Skai-126/CS3237-Final-Project/data/README.md

# Data

Raw sensor recordings are **not committed** (they get large). Store them in the shared drive / cloud bucket and describe each dataset here.

| Dataset | Collected by | Date | Sensors | Rows | Location / link | Notes |
|---|---|---|---|---|---|---|
| | | | | | | |

Small samples (< 1 MB) for testing can go in `data/samples/`.
