Skai-126/CS3237-Final-Project/hardware/datasheets/README.md

# Datasheets

Datasheets (or links to them) for every sensor, actuator and module we use.

| Part | Datasheet |
|---|---|
| | |
