Skai-126/CS3237-Final-Project/hardware/enclosure/README.md

# Enclosure

3D-print models (STL/STEP), CAD source files and case designs go here.
