Skai-126/CS3237-Final-Project/docs/reports/README.md

# Reports & presentations

- `check-in-1/`: slides for Week 9
- `check-in-2/`: slides for Week 11
- `final/`: final report (≤ 20 pages) and presentation (13 Nov)
- `power-analysis/`: battery-life measurements and sampling-interval experiments
