Skai-126/CS3237-Final-Project/docs/ideas/CS3237_Group3_Project_Ideas.docx

CS3237 Introduction to IoT

# Group 3: Project Ideas

Compiled by Shu Kai · Updated 26 September 2026 · For discussion before the proposal deadline

Proposal due: Monday 28 September, 23:59 (Canvas). We need to pick one idea very soon so there is time to write it up. Please read through the ideas and the notes, then vote.

# 1. The brief in short

Group 3: Chang Shu Kai, Loh Wern She, Ng Ren Jie Daniel, Tan Chyn, Toh Xiang Yi Thomas. Lecturer: Jingxian Wang (wang@nus.edu.sg).

We need to build a complete IoT system: ESP32 devices, an optional gateway (smartphone) and a server (laptop or cloud). The focus is on:

- Real-time processing at the edge of critical data that needs instant action (e.g. fall detection, motion-based security).
- Long-term analytics in the cloud (e.g. activity trends).

## Must-haves from the project spec

- At least two ESP32 devices and more than one sensor, with the sensor data used together.
- ESP32s powered by a power bank (more impressive) or mains/laptop, with no communication over the USB cable.
- Communication via REST and/or MQTT; phone gateway (if used) talks to the cloud over Wi-Fi.
- Machine learning in the cloud for analytics, trained on our own sensor data (web data can only supplement it).
- Live inference in the final demo.
- Power-management analysis in the report: battery-life estimate on a LiPo, and the effect of different sampling intervals.
- Extra hardware budget: S$60 per group.
- Bonus points for RTOS features, bare-metal programming, detailed power analysis, 3D printing and other novelty. An AI-agent extension is optional.

## Timeline and grading

When | What | Weight
Mon 28 Sep, 23:59 | Project proposal (Canvas) | 10%
Week 9 | Check-in 1 (feedback on proposal) + Peer Review 1 | 5%
Week 11 | Check-in 2 (preliminary assessment incl. demo) | 5%
Fri 13 Nov | Final demo + presentation | 20%
Fri 13 Nov, 23:59 | Final report (max 20 pages) | 15%
Weeks 9 and 13 | Peer reviews (5% for completing both) | 5%

The project is marked on novelty, difficulty and complexity, technical work (sensing and ML), quality of the final solution, and quality of the presentation, demo and report.

Past projects (novelty is lower if we pick one of these): heat injury prevention, elderly health monitor, dementia monitoring, fall detection, heat stroke detection, weather prediction, fridge stock monitoring, fish tank monitoring, smart rubbish bin, driver state detection, smart baby monitor.

# 2. The ideas

## Idea 1: Smart Clothing Drying Rack

Proposed by Wern She. Predicts when clothes are dry and protects them from rain or high humidity.

Component | Details
ESP32 #1 | Humidity and temperature sensors
ESP32 #2 | Light, moisture and rain sensors
Edge action (real-time) | Retracts or covers the clothes as soon as rain is detected
Actuator | Servo motor moves a cover or the drying rack
ML | Predicts drying time from humidity, temperature, sunlight and fabric weight
Cloud (long-term) | Analyses drying performance across different weather conditions
Demo | Wet cloth samples; simulate rain with a spray bottle

### Notes against the brief

- Clear split between the edge (rain → cover) and the cloud (drying-time prediction).
- Fabric weight means adding a load cell; that also gives a direct "is it dry yet" signal (weight stops dropping).
- Collecting enough real drying runs to train on takes time, so data collection needs to start early.

## Idea 2: Smart Waste Bin with Fill-Level and Odour Prediction

Proposed by Wern She. A bin that detects its fill level, identifies waste conditions and predicts when it needs to be collected.

Component | Details
ESP32 #1 | Ultrasonic sensor for fill level
ESP32 #2 | Gas, temperature, humidity and weight sensors
Edge action (real-time) | Show a warning or operate a lid mechanism
ML | Predict when the bin will overflow, or classify normal vs abnormal odour conditions
Cloud (long-term) | Collection trends and estimated next collection time
Demo | Add objects to the bin and simulate different waste conditions
Stretch | Camera to classify recyclable vs non-recyclable waste (not required for the project to work)

### Notes against the brief

- Cheap and low-risk hardware; mostly kit sensors.
- Smart rubbish bins are on the course's list of past projects, so we would need a clear twist to score on novelty.
- Overlaps with idea 4 and could be merged with it (see below).

## Idea 3: Smart Dormitory Energy-Waste Detector

Proposed by Wern She. Detects appliances being left on unnecessarily.

Component | Details
ESP32 #1 | Current sensor and temperature sensor
ESP32 #2 | Motion, light and door sensors
Edge action (real-time) | Turn off a simulated appliance when no one is present
ML | Learn normal room-usage patterns; tell apart normal use, unusual consumption and possible overheating
Cloud (long-term) | Energy consumption trends and estimated wasted energy
Demo | Leave a lamp or fan running while simulating an empty room

### Notes against the brief

- Strong real-world motivation, and the long-term energy analytics fit the cloud requirement well.
- Switching a real mains appliance is a safety risk. Stick to a low-voltage (USB) fan or lamp driven through a relay.
- A current sensor (e.g. a clamp-on type) will probably need to be bought.

## Idea 4: Smart AI Sorting Bin

Proposed by Chyn. Identifies the type of waste dropped in using computer vision, then sorts it into the correct compartment using a rotating funnel.

Component | Details
ESP32 #1 (base) | Drives a NEMA17 stepper (rotates the funnel to the right bin) and an MG996R servo (tilts the funnel to drop the item)
ESP32 #2 | Ultrasonic sensor for bin fill level and/or a weight sensor for item weight and capacity
ESP32-CAM | Mounted at the top; photographs each item for classification
Edge action (real-time) | After classification, the base rotates the funnel to the matching bin and triggers the servo to drop the item
ML | Image classifier (recyclable material types vs general waste) running on the ESP32-CAM via Edge Impulse or TFLite Micro
Cloud (long-term) | Dashboard showing sorting accuracy over time, waste category breakdown and fill trends per compartment
Demo | Drop different items in front of the camera one at a time; the system classifies each, rotates to the matching bin and drops it in, live
Inspiration | ameru.ai (design); James Dyson Award 2026 "Smart Recycling Bin" by Malaysian students

### Possible extensions

- Extension 1: robot-arm sorting. A separate unit: an ordinary bin where everything is thrown in mixed. A dedicated ESP32 drives an arm with its own camera looking into the bin, picks out individual items and places each into the correct sorted bin. We could 3D-print an open-source arm and focus only on the CV and inverse kinematics.
- Extension 2: multi-bin routing (also works with idea 2). Each bin's ESP32 publishes its fill level over MQTT to a server, which runs a simple nearest-neighbour greedy route over bins above a fill threshold to suggest a collection order.

### Notes against the brief

- The most impressive demo, and it scores on technical difficulty and possible bonus points (3D printing, RTOS timing for the motors).
- The ML here runs on the edge. The spec requires ML in the cloud as well, so we'd add something like fill-level forecasting or model retraining from misclassified images.
- Has the most mechanical risk (funnel, stepper driver, jams). NEMA17 + driver + MG996R + ESP32-CAM need to fit the S$60 budget, and the stepper needs its own power supply.
- The robot arm (extension 1) is a big jump in scope; probably only worth it if the base system is working by Check-in 2.

## Idea 5: Smart Fridge System

Proposed by Thomas. Monitors food availability, storage conditions and consumption patterns, and notifies the user through an app when an item is missing or running low.

Component | Details
ESP32 #1 | Temperature and humidity sensors for fridge conditions
ESP32 #2 | Load cells / weight sensors, door sensor, optional gas/VOC sensor
Edge action (real-time) | Immediately detects a missing or low-stock item and triggers an LED, buzzer or display
Actuator | Servo could automatically close a model fridge door or control an air vent
ML | Learns consumption patterns and predicts when commonly used items will run out; estimates spoilage risk from temperature, humidity, storage time and gas readings
App | Notifications such as "Milk is running low" or "Eggs are no longer detected"
Cloud (long-term) | Consumption history, fridge conditions and predicted restocking times
Demo | Put items on the load cells, remove one, and show the app receiving a notification

### Notes against the brief

- Clean, easy-to-explain demo, and the phone app naturally fills the optional gateway role.
- "Monitoring food stock levels in fridge" is on the list of past projects, so novelty would need to come from the freshness/spoilage side.
- Consumption patterns take weeks to build up for real; we would likely need to simulate usage to train the forecasting model.

## Idea 6: Smart Wireless Interference Detection System

Proposed by Ren Jie. A distributed system that detects areas with abnormal Wi-Fi or cellular connectivity and identifies possible interference.

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

### Notes against the brief

- Novel compared to the past-project list and needs no extra hardware, and the multi-node comparison is a real use of "collective" sensing.
- The spec requires more than one sensor. Wi-Fi measurements come from the radio, so we should add at least one physical sensor (e.g. temperature or motion) to be safe.
- The system should only detect interference. Deliberately jamming radio signals is illegal, so the demo must stay with the safe methods listed above.
- Few natural actuators; the edge action is mainly an alert.

## Idea 7: Predictive Maintenance for Motors and Fans

NEW Proposed by Claude (new suggestion). Monitors a motor or fan for abnormal vibration, heat and current draw, shuts it down instantly when something dangerous happens, and learns its wear pattern over time. This is an Industrial IoT use case.

Component | Details
ESP32 #1 | IMU / accelerometer (vibration) + temperature sensor clipped onto the fan or motor housing
ESP32 #2 | Current sensor on the fan supply + relay to cut power; optional microphone for acoustic signature
Edge action (real-time) | Vibration or temperature crosses a danger threshold → relay cuts power within milliseconds, buzzer/LED alert
Actuator | Relay (power cut-off); optional fan-speed control
ML | Autoencoder trained on "healthy" data → anomaly score; FFT features + SVM/NN to classify fault type (imbalance, obstruction, loose mount)
Cloud (long-term) | Anomaly score trend, wear over time, estimated time until maintenance, fault log
Demo | Run a small USB/desk fan normally, then tape a coin to one blade or lightly obstruct it; the system detects it and cuts power live

### Notes against the brief

- Industrial IoT is a syllabus topic, and autoencoders/SVMs are covered in lectures.
- Clear edge/cloud split, and data is fast to collect (hours of labelled vibration data in a day). Not on the past-projects list.
- Use a low-voltage (USB/12 V) fan, not a mains appliance, for the relay.
- Running the FFT on the ESP32 and sending only features is good power-analysis material; FreeRTOS tasks and a 3D-printed sensor mount can earn bonus points.

## Idea 8: Dengue Breeding-Site Monitor

NEW Proposed by Claude (new suggestion). Detects stagnant water in containers around the home (plant saucers, pails, gully traps) and drains or flags them before mosquitoes can breed. Tailored to Singapore.

Component | Details
ESP32 #1 | Water-level sensor + waterproof temperature probe (DS18B20) in a container
ESP32 #2 | Second container / location, plus ambient temperature, humidity and light sensors
Edge action (real-time) | Water has stood longer than a threshold → servo tips/opens a drain, LED/buzzer alert
Actuator | Servo tips the container or opens a small drain valve
ML | Breeding-risk model from standing-water duration, water temperature, humidity and rainfall; can be supplemented with NEA dengue-cluster and weather data
Cloud (long-term) | Which containers fill up most often, weekly risk trend, correlation with rainfall, risk per location
Demo | Pour water into the tray; after an accelerated timer the node flags it and the servo drains it; dashboard updates

### Notes against the brief

- Very relevant to Singapore and not on the past-projects list, so it scores well on novelty.
- Stagnant water changes slowly, so the demo and data collection need an accelerated time scale.
- Needs waterproofing, and the tipping/draining mechanism needs a simple, reliable design.

## Idea 9: Library / Study-Spot Seat Monitor

NEW Proposed by Claude (new suggestion). Shows which study seats are really free, detects "seat hogging" (belongings left with nobody there) and forecasts how busy a study area will be.

Component | Details
ESP32 #1 (per desk) | PIR or mmWave presence sensor + pressure pad / load cell on the seat
ESP32 #2 (per desk / area) | Microphone for noise level + light sensor; a second desk for multi-node data
Edge action (real-time) | Items on seat but no person for > N minutes → LED turns amber ("hogged"); instant status change when someone sits or leaves
Actuator | RGB LED / small display showing free / occupied / hogged
ML | Occupancy classifier fusing presence + pressure + noise; LSTM forecasting of area occupancy by time of day
Cloud (long-term) | Occupancy history, peak-hour trends, hogging statistics, predicted free seats in the next hour
App / gateway | Phone app or web page showing a live seat map and forecasts
Demo | Sit down → green to red; leave a bag and walk away → amber after a shortened timer; dashboard shows live map

### Notes against the brief

- A problem every NUS student and marker knows, with a clear, quick demo and cheap hardware.
- Real occupancy data takes time to collect; we would log in an actual study area or simulate usage patterns.
- Keep it privacy-friendly: no cameras, only presence, pressure and noise levels.

# 3. Side-by-side comparison

A quick read of how each idea lines up with what the markers look for. These are my rough judgements to start discussion, not final scores.

Idea | Novelty | Technical depth | Hardware risk | Extra cost | Data collection | Demo impact
1. Drying rack | Medium | Medium | Low | Low | Slow | Good
2. Waste bin | Low | Medium | Low | Low | Medium | OK
3. Energy detector | Medium | Medium | Medium | Medium | Medium | OK
4. AI sorting bin | Med–High | High | High | Medium | Medium | Excellent
5. Smart fridge | Low–Med | Medium | Low | Low | Slow | Good
6. Interference detector | High | Medium | Low | None | Easy | OK
7. Predictive maintenance | Med–High | High | Low | Low | Easy | Good
8. Dengue monitor | High | Medium | Medium | Low | Slow | Good
9. Seat monitor | Medium | Medium | Low | Low | Medium | Good

## Recommendation (for discussion)

- Highest ceiling: Idea 4 + Idea 2 merged. Camera classification and sorting at the edge, with fill-level and waste-mix forecasting across bins in the cloud (this also fixes idea 4's missing cloud ML). To reduce mechanical risk, use a simple servo trapdoor into 2–3 compartments instead of the stepper funnel, and keep the robot arm as a stretch goal.
- Best balance of risk and marks: Idea 7 (predictive maintenance). Cheap, easy to collect lots of data, maps directly to lecture content (autoencoders, Industrial IoT), and the coin-on-fan-blade demo is simple and reliable.
- Safe option: Idea 1 with a Singapore angle. Sudden afternoon storms and HDB laundry poles; the cloud model can add NEA weather data to our own sensor data.

## Possible merge

Ideas 2 and 4 fit together well: the AI sorting bin (edge: camera classification + funnel sorting) plus fill-level/odour sensing and multi-bin MQTT routing (cloud: fill forecasting and collection-route suggestions). That covers both the real-time edge action and the long-term cloud ML that the brief asks for.

# 4. Next steps

- Everyone: vote for your top 2 ideas in the group chat by Sunday 27 Sep.
- Once chosen, split the proposal sections (template: Problem Statement, Proposed Solution, Hardware, ML Models, System Architecture diagram, Other Features, Progress, Challenges, Timeline, References).
- Check the parts list against the kit and the S$60 budget.
- Open question for Jingxian: the spec says a 2-page proposal but the template says 3 pages. Which applies?

CS3237 Group 3 · Project ideas · Page
