Skai-126/CS3237-Final-Project/docs/README.md

# Documentation

| Page | Description |
|---|---|
| [Project brief](project-brief.md) | Summary of the course's project specification and requirements |
| [Proposal](proposal/) | Submitted ZoneSort proposal, changes since, and feedback |
| [Ideas](ideas/) | Candidate ideas we considered before choosing ZoneSort |
| [Meeting notes](meeting-notes/) | Notes from group meetings and check-ins |
| [Reports](reports/) | Final report, check-in slides, power analysis |
