Skai-126/CS3237-Final-Project/docs/meeting-notes/README.md

# Meeting notes

Name files `YYYY-MM-DD.md` (e.g. `2026-09-26.md`). Copy the template below.

```markdown
# Meeting – YYYY-MM-DD
**Attendees:**
**Agenda:**
1.

## Decisions
-

## Action items
| Task | Owner | Due |
|---|---|---|
|  |  |  |
```
