Skai-126/CS3237-Final-Project/docs/proposal/architecture.png

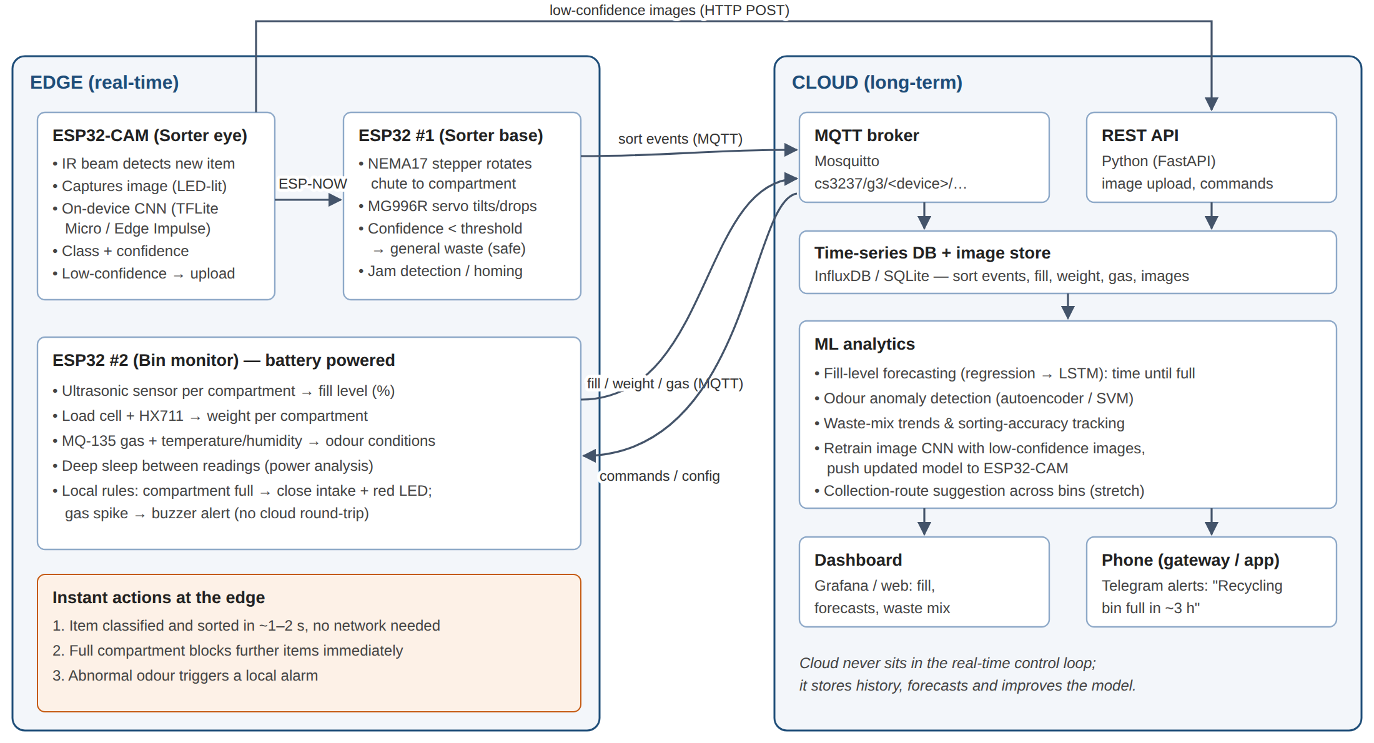
docs/proposal/architecture.png
