Skai-126/CS3237-Final-Project/docs/reports/final/figures/dashboard.png

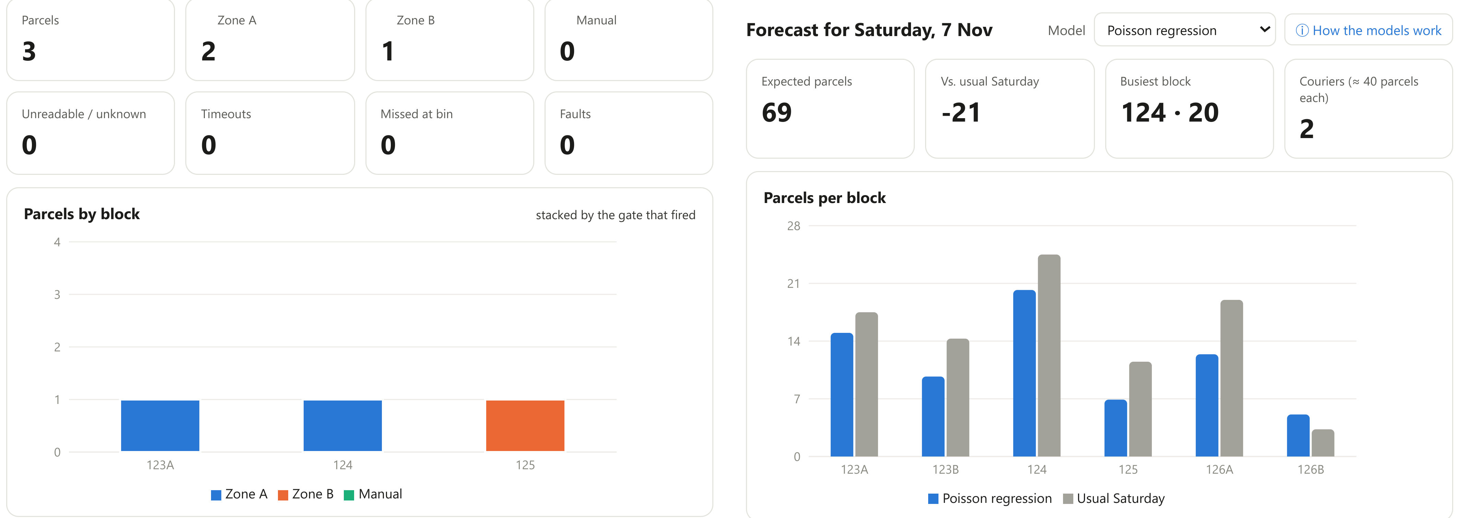
docs/reports/final/figures/dashboard.png
