Skai-126/CS3237-Final-Project/docs/reports/final/figures/forecast_daily_total.png

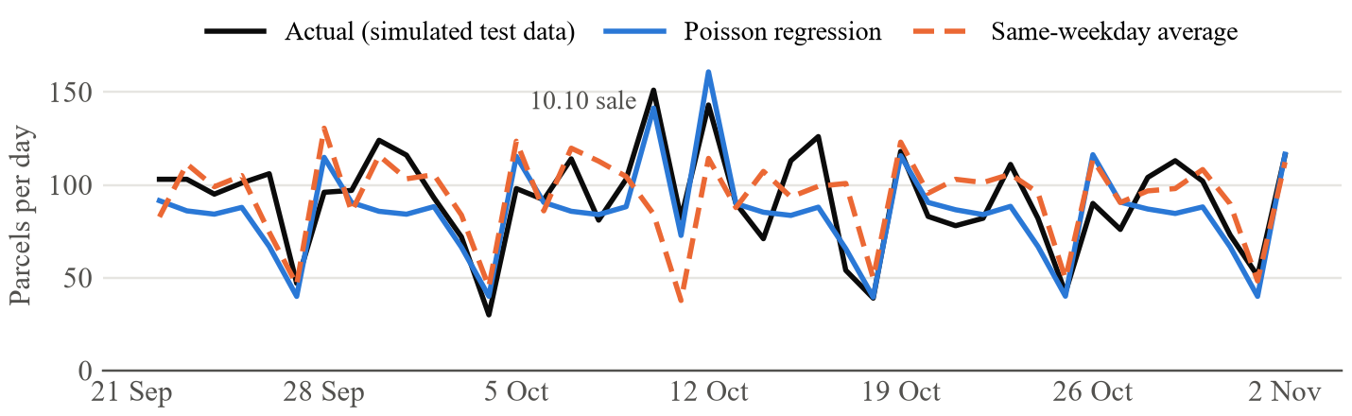
docs/reports/final/figures/forecast_daily_total.png
