Skai-126/CS3237-Final-Project/docs/reports/final/figures/system_architecture.png

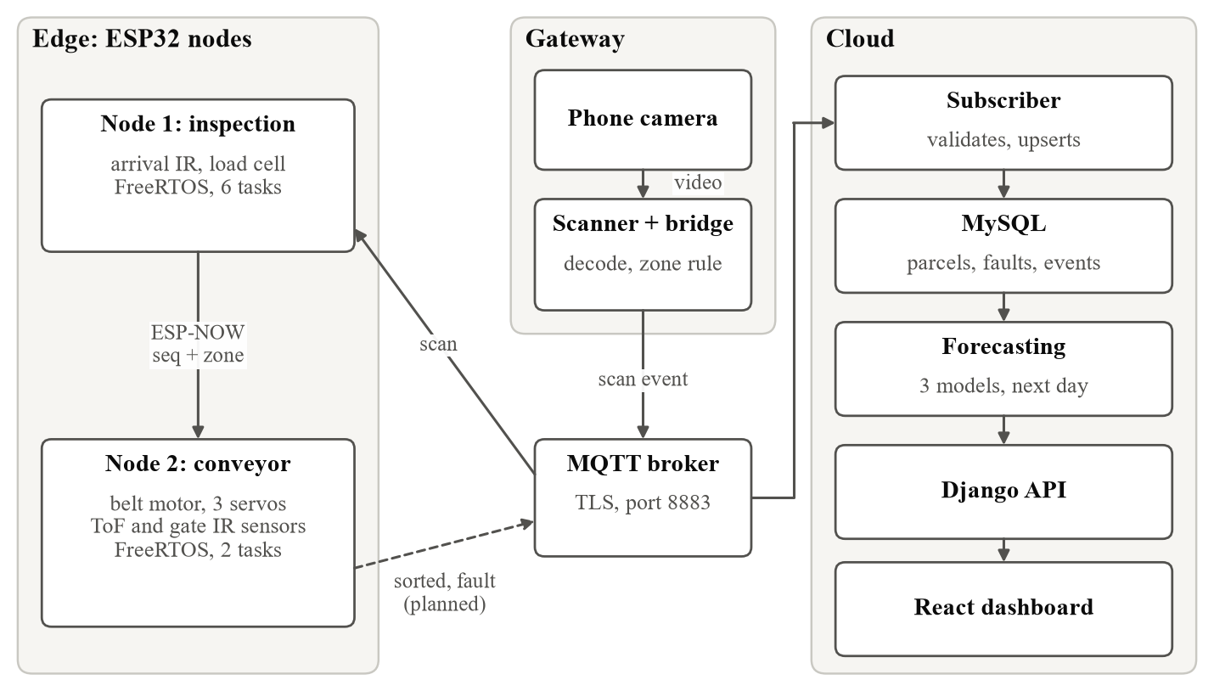
docs/reports/final/figures/system_architecture.png
