Skai-126/CS3237-Final-Project/hardware/enclosure/servo_and_OA_holderver3_mirrored.step

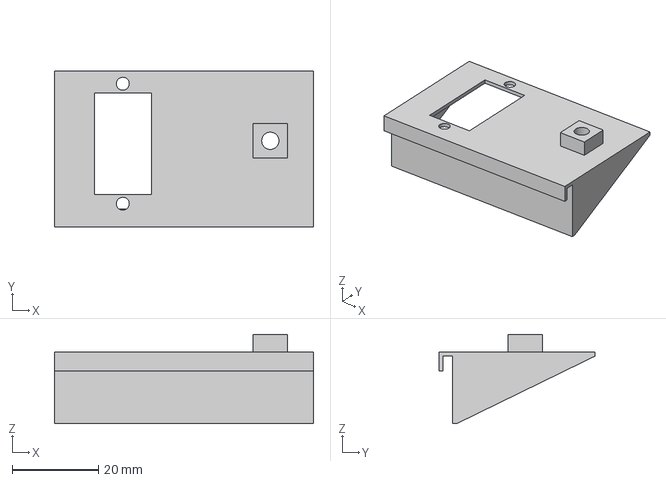
[picture p9: CAD file, 2026-10-30]
hardware/enclosure/servo_and_OA_holderver3_mirrored.step
60.0 x 36.2 x 20.6 mm
