Skai-126/CS3237-Final-Project/hardware/enclosure/Conveyer_belt_box.step

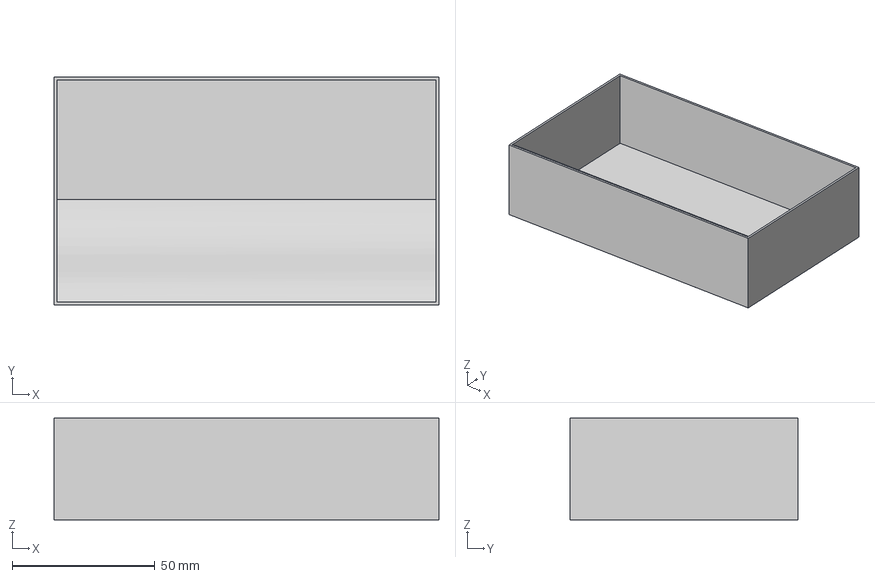
[picture p10: CAD file, 2026-10-30]
hardware/enclosure/Conveyer_belt_box.step
135.0 x 80.0 x 35.7 mm
