Skai-126/CS3237-Final-Project/hardware/enclosure/Motor attachement.step

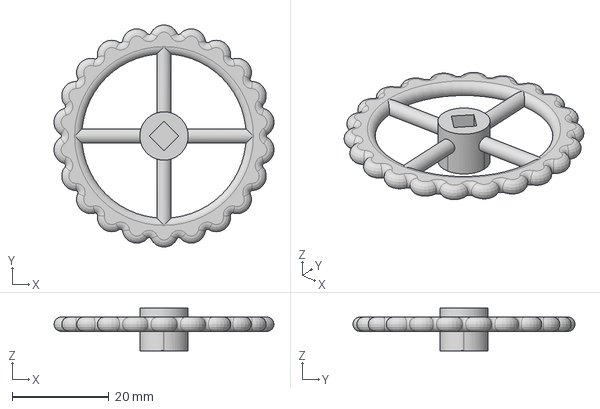
[picture p11: CAD file, 2026-10-30]
hardware/enclosure/Motor attachement.step
45.5 x 46.0 x 8.80 mm
