Skai-126/CS3237-Final-Project/hardware/enclosure/Conveyer_belt_manual_box.step

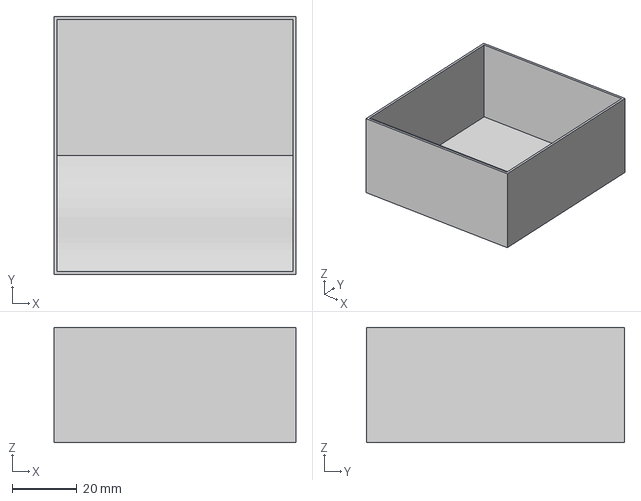
[picture p12: CAD file, 2026-10-30]
hardware/enclosure/Conveyer_belt_manual_box.step
75.0 x 80.0 x 35.7 mm
