Skai-126/CS3237-Final-Project/hardware/enclosure/TOF_holder.step

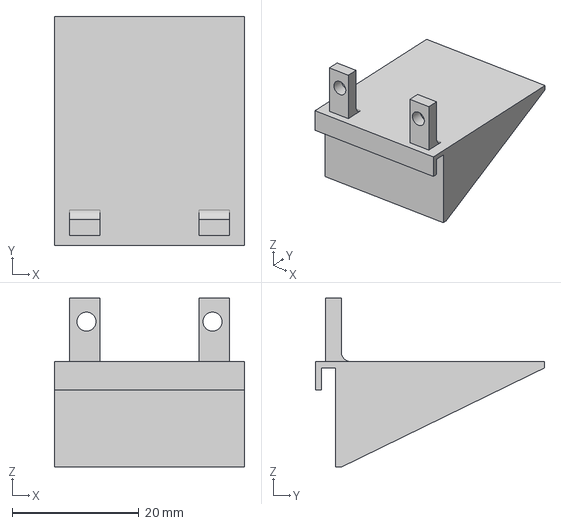
[picture p13: CAD file, 2026-10-30]
hardware/enclosure/TOF_holder.step
30.0 x 36.2 x 26.6 mm
