Skai-126/CS3237-Final-Project/hardware/enclosure/Ramp_Funnel.step

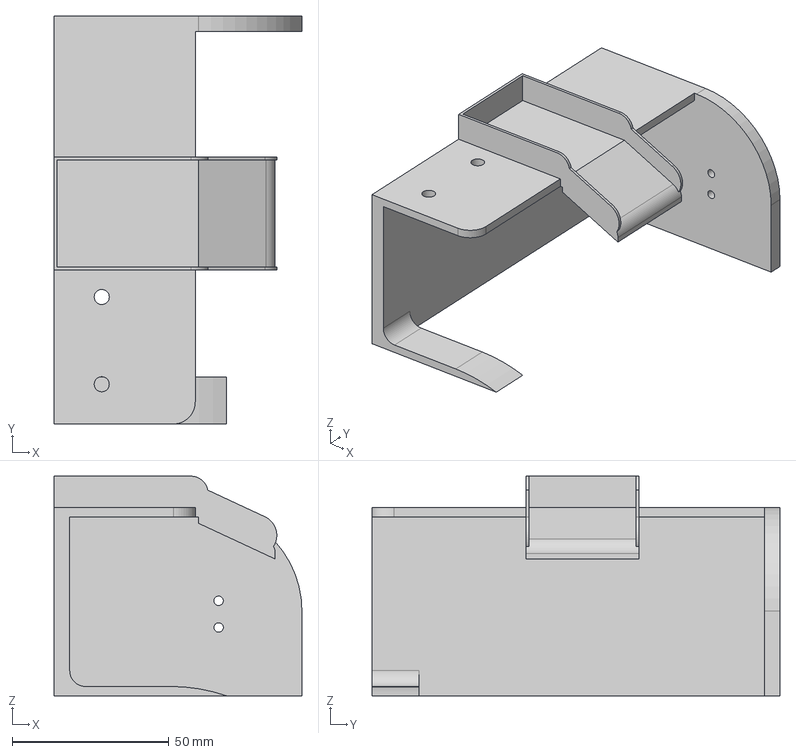
[picture p14: CAD file, 2026-10-30]
hardware/enclosure/Ramp_Funnel.step
79.0 x 130.0 x 70.0 mm
