Skai-126/CS3237-Final-Project/(list of files, cad)

Other CAD files:
hardware/enclosure/servo_and_OA_holderver3.step
