Skai-126/CS3237-Final-Project/cloud/ZoneSort Dashboard.pdf

3

2

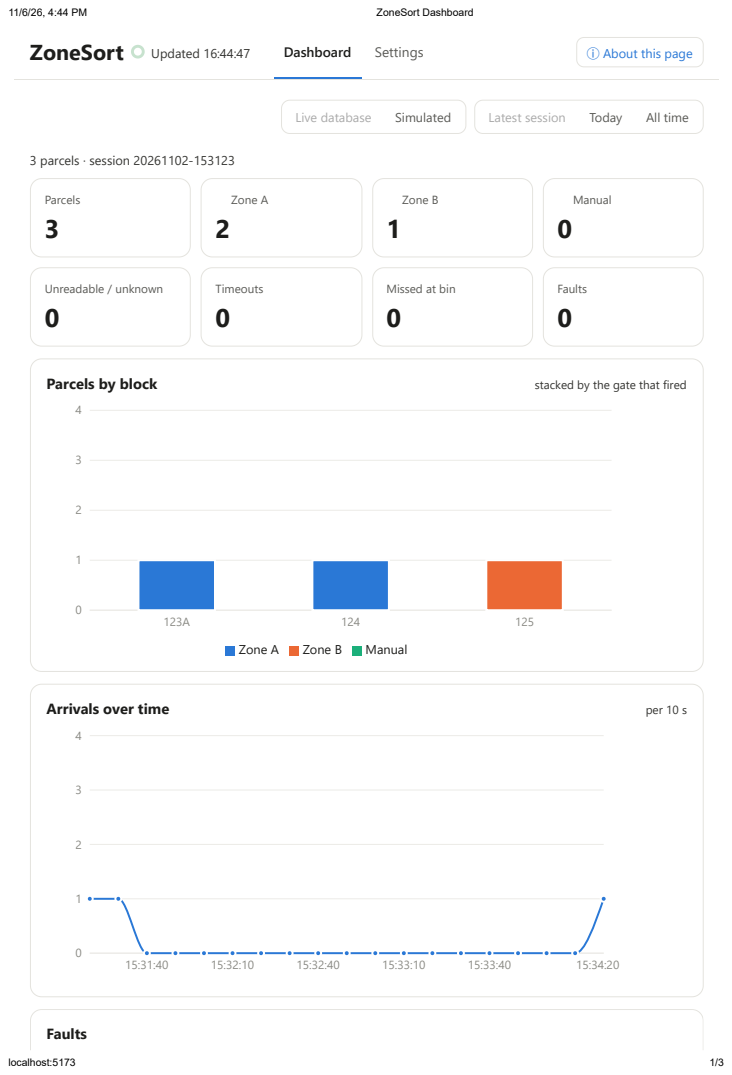
[picture p16: page 1]
Live database; Simulated; Latest session; Today; All time; 3 parcels · session 20261102-153123; Parcels; Zone A; Zone B; Manual; Unreadable / unknown 0; Timeouts 0; Faults 0; Parcels by block; stacked by the gate that fired; Arrivals over time; per 10 s; Faults; ZoneSort Updated 16:44:47; Dashboard; Settings; ⓘ About this page; ZoneSort Dashboard; localhost:5173

Missed at bin

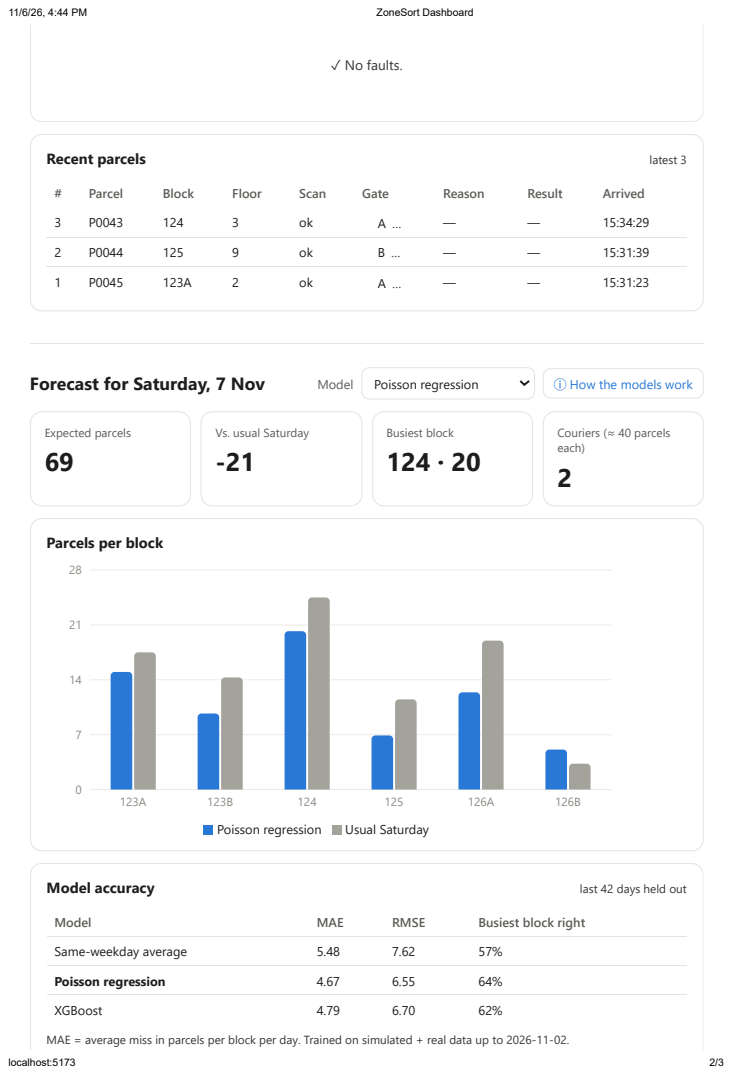
[picture p17: page 2]
✓ No faults.; Recent parcels; latest 3; Forecast for Saturday, 7 Nov; Model; Poisson regression; ⓘ How the models work; Expected parcels 69; Busiest block 124 · 20; Couriers (≈ 40 parcels each) 2; Model accuracy; last 42 days held out; Same-weekday average; XGBoost; Parcel; Block; Floor; Scan; Gate; Reason; Result; Arrived; Usual Saturday; MAE; RMSE; Busiest block right

Vs. usual Saturday

Parcels per block

MAE = average miss in parcels per block per day. Trained on simulated + real data up to 2026-11-02.

123A | 15.0 | 17.5 | 21 | 18
123B | 9.7 | 14.3 | 27 | 2
124 | 20.2 | 24.5 | 34 | 22
125 | 6.9 | 11.5 | 7 | 8
126A | 12.4 | 19.0 | 16 | 16
126B | 5.1 | 3.3 | 12 | 7
Block | Forecast | Usual Saturday | Today | Last week
