Skai-126/CS3237-Final-Project/(commit log)

2026-09-25 Add hardware/wiring folder
2026-09-25 Add hardware/enclosure folder
2026-10-16 cloud de
2026-10-18 Add parcel forecasting pipeline and live dashboard
    ml/: traffic simulator, daily per-block features, baseline / Poisson /
    XGBoost training with time-ordered evaluation, and next-day forecast.
    History mixes real MySQL events (on days the prototype ran) with
    simulated traffic on the other days.
    cloud/: Streamlit dashboard with live counts, faults, recent parcels and
    the next-day forecast panel. Mark the event schema as agreed.
2026-10-18 change of framework of dashboard
2026-10-18 changes on current framework
2026-10-30 Hardware, sample code, CAD files, updated wiring diagram
2026-11-06 Final version with PCA
    Changed servo motor control to PCA
2026-11-12 Add files via upload
    Added gate servo
2026-11-12 Node 1: oversize box fault on zonesort/fault, fix ToFResult compile error
    Move struct ToFResult above the first function so Arduino's generated
    prototypes compile. Publish an oversize fault (source node1, type
    oversize) when a ToF-measured box exceeds MAX_LENGTH/WIDTH/HEIGHT_MM.
2026-11-12 gate servo triggered on binarrival and zone
2026-11-12 Node 2: handle Node 1 bin IR (ESP-NOW type 5) like a typed BIN A/B/M
    Node 1 sends WIRE_BIN_ARRIVED (5) with the bin letter when a bin IR fires.
    Node 2 dropped it as an unknown type; it now queues a BinArrival event for
    that bin, the same path as the serial BIN command.
